NguyenVuQuocMinh/cmos-ldo-regulator-180nm/doc/ldo_hand_design.pdf

# A 1.5 V, 50 mA PMOS Low-Dropout Regulator in 0.18 µm CMOS

### Part 2: Hand calculation of W/L from the specification, and ngspice verification

### November 2026

Abstract

This note sizes a PMOS low-dropout regulator from a written specification and checks it in ngspice. Section 2 extracts square-law parameters from the 0.18 µm BSIM3 model. Section 3 computes every W/L, bias current and resistor step by step, following the system-level LDO design procedure of Rincón-Mora [1, 2]: topology, feedback network, pass device, open-loop gain, transient budget, gain stage, buffer and quiescent current. Section 4 verifies the design, reports four iterations, explains each gap between hand calculation and simulation, and lists the corner results. The final design meets every specification at the nominal point. All equation, lemma, proposition and corollary numbers refer to Part 1 (ldo_theory_proofs.pdf), where each formula is proved; tables, figures and sections refer to this note.

## Contents

1 Specification and architecture | 1
2 Device parameters | 2
3 Hand design: the LDO design procedure | 3
4 Simulation | 5
5 Limitations and next steps | 8
A Reproducing the results | 8

## 1 Specification and architecture

Table 1: Specification. Typical model, T = 27 ◦C unless stated. The last column is the simulated value of the final design (v4, Section 4).

Quantity | Condition | Spec | Simulated (v4)
Input voltage VIN | | 1.7–1.9 V (nom. 1.8 V) | –
Output voltage VOUT | | 1.50 V | 1.4954–1.5053 V
Load current IL | | 0.1–50 mA | –
Dropout voltage | IL = 50 mA, VOUT within 1 % | ≤ 200 mV | 141 mV
Output capacitor | ceramic | CL = 2.2 µF, RESR = 0–50 mΩ | –
Phase margin | all loads, all RESR in range | ≥ 45◦ | 57.0

◦
| | | (worst, incl. corners)
PSRR | 1 kHz, IL = 50 mA, VIN = 1.8 V | ≥ 30 dB | 31.0 dB
Load regulation | IL: 0.1→50 mA | |∆VOUT | ≤ 15 mV | 9.9 mV
Line regulation | VIN : 1.7→1.9 V | ≤ 35 mV/V | 29.9 mV/V (worst)
Quiescent current | excl. IL, incl. divider | ≤ 100 µA | 74.9 µA
Load transient | 0.1↔50 mA, 1 µs edges | |∆VOUT | ≤ 50 mV | 9.9 mV

Process and tools. The transistor model is the 0.18 µm BSIM3v3.1 file cmos180.lib (1.8 V devices, tox = 4.1 nm) from the analog-IC coursework. Simulations use ngspice-46 in batch mode, driven by Python scripts; every number in this note is read from the script outputs. The reference voltage VREF = 0.6 V and the bias current IREF = 5 µA are ideal sources (a bandgap is outside the scope of this note).

Architecture (Fig. 1).

- Pass device MP : a PMOS. A PMOS can work with VIN − VOUT down to its saturation voltage, which is what makes a low dropout possible.
- Feedback divider R1, R2: it feeds back the fraction β = R2/(R1 + R2) of VOUT .
- Error amplifier (EA) M1–M5: a five-transistor OTA with a PMOS input pair, which works at VREF = 0.6 V. An NMOS pair would need its input common mode above VGS + VDS,sat ≈ 0.75 V.
- Buffer MB: a PMOS source follower with its bulk tied to its source, biased by MBS. It drives the large gate capacitance of MP from a low impedance (Part 1, Section 4.2).
- Load: the off-chip capacitor CL with its series resistance RESR. The load current is an ideal current sink.

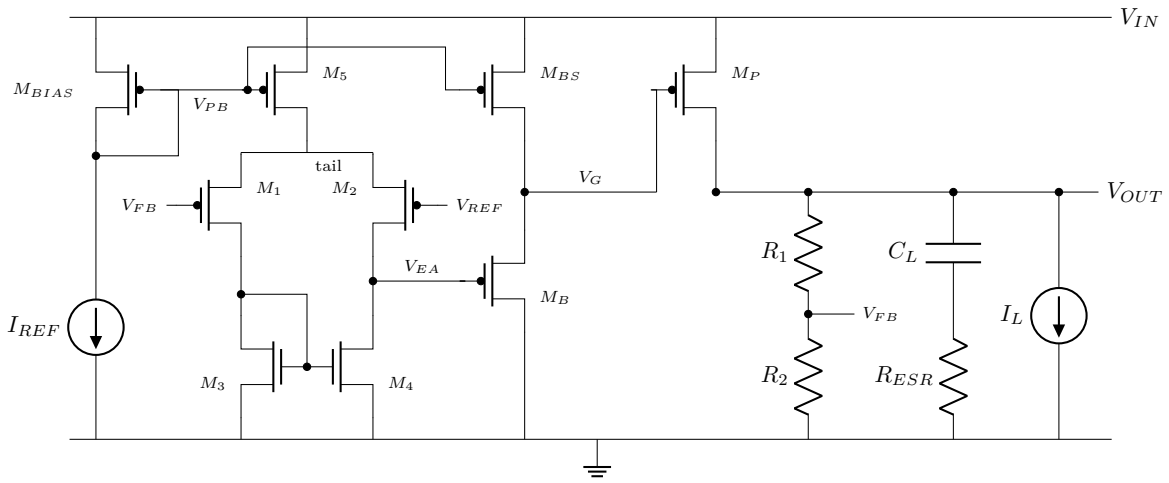
[picture p2: figure]
VIN; MBIAS; IREF; tail; VREF; VEA; MBS; VOUT; RESR

Figure 1: LDO schematic. M1 (gate VF B) sits on the diode side of the mirror, M2 (gate VREF ) on the output side; Lemma 4 shows that this gives negative feedback. Bulk of every PMOS is VIN except M1, M2 (tail node) and MB (its source).

## 2 Device parameters

Extraction. For each device type and length, ngspice sweeps ID–VGS at |VDS| = 0.9 V (W = 10 µm). By (1), √
ID is a straight line in VGS. Its slope gives K′ and its intercept gives VTH; the fit uses VOV = 0.1–0.3 V. Next, λ is the slope of ID–VDS at VOV = 0.2 V over |VDS| = 0.6–1.2 V, divided by ID. Table 2 lists the results, and Fig. 2 shows the simulated gm/ID.

Table 2: Square-law parameters extracted from cmos180.lib (script char_devices.py).

| L = 0.18 µm | 0.5 | 1 | 2 | 3
NMOS VTH (V) | 0.479 | 0.459 | 0.428 | 0.410 | 0.404
NMOS K′
(µA/V²
) | 219 | 218 | 217 | 217 | 216
NMOS λ (V−1
) | 0.292 | 0.101 | 0.080 | 0.059 | 0.045
PMOS |VTH| (V) | 0.465 | 0.431 | 0.412 | 0.399 | 0.394
PMOS K′
(µA/V²
) | 71.4 | 53.9 | 49.9 | 48.0 | 47.4
PMOS λ (V−1
) | 0.342 | 0.118 | 0.077 | 0.046 | 0.032

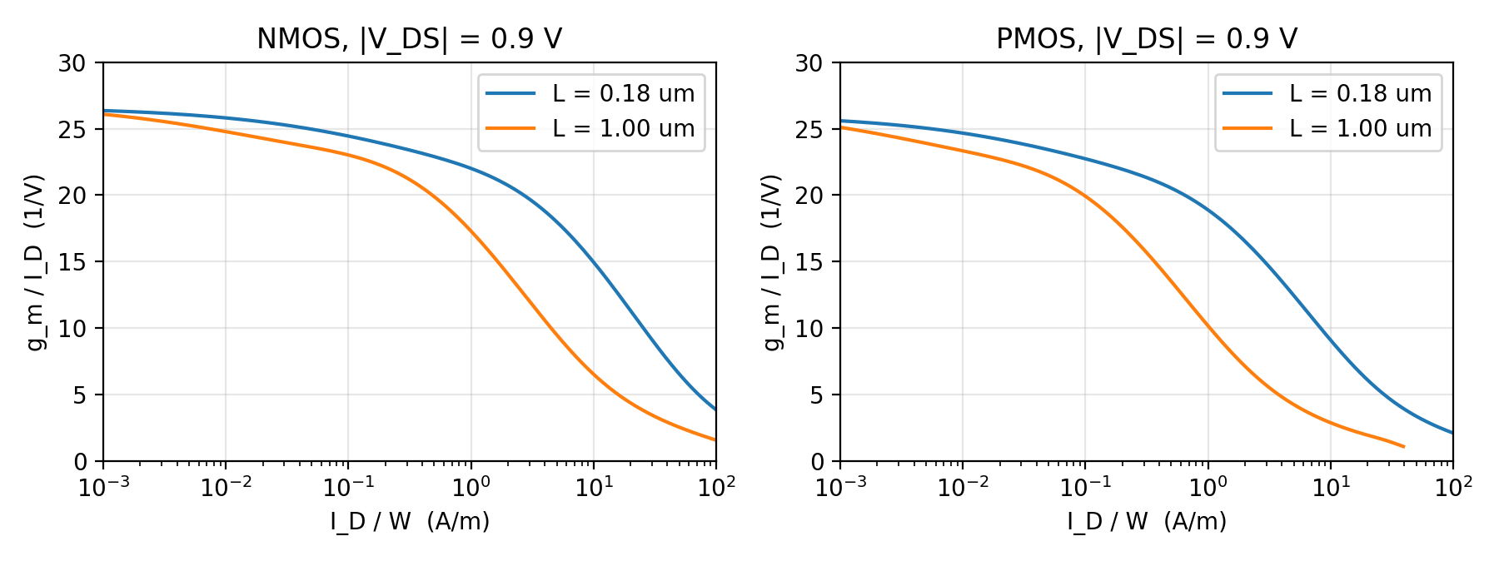
[picture p3: figure]

Figure 2: Simulated gm/ID versus current density. The square law predicts gm/ID = 2/VOV , which is 20 V−1 at
VOV = 0.1 V. The real device gives about 17 V−1
there (moderate inversion) and levels off near 1/(nVT ) ≈ 26 V

−1
in
weak inversion; this is one source of the hand-versus-simulation gap in Section 4.3.

Note on the model file. ngspice reports that the model parameters XL and XW are not recognised and ignores them. In this file XL = 0 and XW = −10 nm, so the effect is a 10 nm width change and is negligible for the widths used here.

## 3 Hand design: the LDO design procedure

The sizing follows the system-level design procedure of Rincón-Mora: the design considerations of [1, Chapter II] (AC analysis, transient analysis, pass device, amplifier), the pass-element choice of [1, Section 6.1], and the dropout, buffer and gain-stage equations of [2, Sections II–IV]. Each formula is used in the form proved in Part 1. The script design_flow.py carries out the eight steps below, and each number is quoted from its output. Steps 6 and 7 run twice. Pass A uses square-law parameters only. Pass B replaces gm/ID and λ by the values read at the simulated operating point of the previous design (v3, Section 4.1), the usual second pass of a hand design. The result is the final design v4.

Step 1 – Topology. Of the five pass elements compared in [1, Table 6.1], the common-source PMOS has the lowest dropout (VSD,sat) together with a low quiescent current, and the reference calls it the best overall choice, so MP is a PMOS. Its large gate capacitance must not load the high-impedance gain stage, so a buffer isolates the two (the buffered architecture of [1, Fig. 2.7]). The gain stage is the five-transistor OTA of [2, Fig. 8(a)], which needs only a small common-mode range around VREF [2, Section IV]. With VREF = 0.6 V a PMOS input pair is used (Step 6a). The buffer is a class-A PMOS source follower MB biased by MBS, with its bulk tied to its source.
Step 2 – Feedback network [1, Section 2.1]. The divider current is a quiescent-current overhead, so it is kept small: IR = 10 µA. Then β = VREF /VOUT = 0.40, R2 = VREF /IR = 60 kΩ and R1 = (VOUT − VREF )/IR = 90 kΩ.
Step 3 – Pass device [2, Eqs. (12)–(14)], [1, Section 2.3]. Two conditions bound W/L from below.
- Dropout. The buffer can pull VG down to VG,min = VOV 4 + VSG,B ≈ 0.80 V (VSG,B is checked in
Step 6b). At VIN,min the available drive is VSG,P = 0.899 V, i.e. VOV = 0.434 V. Carrying Imax at VSD = VDO (triode, (7), the exact form of [2, Eq. (12)]) needs W/L ≥ 10465.
- Saturation at VIN,nom. The loop gain and the PSRR collapse in triode (Corollary 20), so MP must stay saturated at the nominal input. By (6) with a 10 mV margin, W/L ≥ 16644.

The saturation condition is binding. Rounding up to fingers of 10 µm gives MP = 300 × 10 µm/0.18 µm (W/L = 16667). With this size the dropout point needs only V

DO
SG,P = 0.775 V, below the available 0.899 V, and the on-resistance at the available drive is Ron = 1/(K′ W
L

VOV ) = 1.93 Ω [2, Eq. (13)]. At full load VSG,P = 0.755 V and gm,P = 0.345 S. At light load (weak inversion) the simulated ID–VSG curve of one finger gives VSG,P = 0.366 V and gm,P = 2.38 mS, so ∆VSG,P = 389 mV. The gate capacitance, Cpar in [1, 2], is CG =

2
3W LCox + 2W Cov = 6.96 pF.

Step 4 – Open-loop gain from regulation and PSRR [1, Eq. (2.9)]. Equation (2.9) of [1] gives the closed-loop output resistance Ro,pass/(1+Aolβ) ≈ 1/(Ggm,P ) with G = βAEAAB. Since gm,P changes by two
decades over the load range, it is integrated over the range, which is Corollary 6(b): |∆VOUT | = ∆VSG,P /G.
Each specification gives a lower bound on G: PSRR (Proposition 19): G ≥ 31.6; load regulation: G ≥ 25.9; line regulation (Corollary 6c): G ≥ 28.6. The PSRR is binding: Gmin = 31.6.
Step 5 – Transient budget [1, Eqs. (2.10)–(2.12)]. By Proposition 23, the 50 mV limit for the ∆I = 49.9 mA step allows a response time

∆t1,max =

CL (∆Vtr − ∆I RESR)
∆I

= 2.18 µs.

The loop reaction time 1/(2πfu) and the gate slew time (20) must fit in this budget. Steps 6 and 7 check both.

Step 6 – Gain stage [1, Section 2.4], [2, Section IV].
(a) Common-mode range around VREF . For a PMOS pair with an NMOS mirror, VIC,max = VIN,min − VSD,sat5 − VSG1 = 1.038 V and VIC,min = VGS3 − |VTH1| = 0.142 V. VREF = 0.6 V lies inside.
(b) Output swing. The gain stage must move the buffer over the whole range from MP almost off to full drive [2, Section IV]. For this topology that is the window of Proposition 8: 0.522 V ≤ VSG,B ≤ 0.775 V. Its centre, VSG,B = 0.65 V, sets VOV,B = 0.22 V.
(c) Gain and channel lengths. With VOV 1 = 0.1 V, AEA = (2/VOV 1)/(λp + λn) (Lemma 10). By Proposition 16, AEA pEA is fixed for a given L12 and falls as L12 grows, so any gain above the need costs bandwidth. The rule is therefore: the shortest L12, then the shortest L34, whose square-law G exceeds Gmin by 6 dB. The margin covers the known optimism of the square law (gm/ID too high, λ too low; Fig. 2, Section 4.3), which iterations v1 and v2 measured. Table 3 lists the candidates; the rule selects L12 = 1 µm, L34 = 3 µm, with AEA = 164 and G = 64.1.
(d) Current. By Proposition 16, pEA does not depend on ID1, so the bandwidth requirement of [1, Section 2.4] does not fix it; ID1 = 20 µA per side is a budget choice. Then pEA = 2.02 MHz (Pass A).

Table 3: Step 6c, square-law gain for each pair of channel lengths (VOV 1 = 0.1 V, AB = 0.979). The first row that meets G ≥ 2Gmin = 63.2 in the order (L12, L34) is chosen.

L12 (µm) | L34 (µm) | AEA | G | G/Gmin | meets rule
1 | 1 | 127 | 49.8 | 1.58 | no
1 | 2 | 147 | 57.7 | 1.82 | no
1 | 3 | 164 | 64.1 | 2.03 | yes
2 | 1 | 159 | 62.2 | 1.97 | no
2 | 2 | 192 | 75.0 | 2.37 | yes
2 | 3 | 220 | 86.1 | 2.72 | yes
3 | 1 | 177 | 69.5 | 2.20 | yes
3 | 2 | 219 | 85.8 | 2.71 | yes
3 | 3 | 257 | 100.7 | 3.19 | yes
Step 7 – Buffer [2, Eq. (3)], [1, Section 2.4]. The parasitic pole at the gate of MP , pB = gout/(2πCG) (Lemma 11; P3 in [2]), must lie above fu. The worst case is full load [1, Section 2.1] with RESR → 0. Proposition 15 with a target of 60◦

(the specification, 45◦

, plus 15◦
for corners) gives arctan(fu/pB) ≤ 30◦ − arctan(fu/pEA).
- Pass A. fu = 1.60 MHz and arctan(fu/pEA) = 38.3

◦

leave −8.3◦
for the buffer: no bias current reaches the target. The square-law gain, and with it fu, is too high, which is exactly the optimism the 6 dB margin of Step 6c anticipated.
- Pass B. At the operating point of v3: gm1/ID1 = 16.6 V−1

, λ2 = 0.102, λ4 = 0.069 V−1 , so AEA = 97.4
and G = 38.2 (still 1.21 × Gmin). Then fu = 893 kHz, pEA = 2.83 MHz, arctan(fu/pEA) = 17.5

◦
,
and the buffer pole must be at least pB = 4.03 MHz: gmB ≥ 2πCGpBAB = 0.173 mS. With the operating-point gmB/IB = 9.47 V−1
this needs IB ≥ 18.2 µA.
- Slew current. For the load release only IB charges CG (Remark after Proposition 23). With 1/(2πfu) = 0.178 µs, the budget of Step 5 leaves tsr ≤ 2.00 µs, so (20) needs IB ≥ 1.35 µA. The pole condition is binding.

IB = 20 µA (the next multiple of IREF ; v3 used 30 µA). Predictions: pB = 4.42 MHz, PM = 61.1

◦
(RESR = 0)
and 68.1

◦
(RESR = 10 mΩ), tsr = 0.14 µs. The load-step excursion by (19) is at most 29 mV with the conservative tloop = 1/fu of [1], or 7.6 mV with tloop = 1/(2πfu), both within 50 mV. MBS mirrors IREF (WBS = 20 µm) and MB is sized by (1) at VOV,B: WB = 8 µm, LB = 0.5 µm.
Step 8 – Quiescent current and current efficiency [2, Eq. (1)]. IQ = IREF + 2ID1 + IB + IR = 75 µA (v3: 85 µA), within the 100 µA limit. The current efficiency IL/(IL + IQ) is 57 % at 0.1 mA and 99.85 % at 50 mA. Pass B removes the 10 µA by which the buffer of v3 was over-biased, which is the aim of the procedure: the least quiescent current that the stability and transient requirements allow [2].

Table 4: Final device sizes (v4). MBIAS, M5 and MBS form a mirror; the widths set the current ratios. Only MBS and MB differ from v3.

Device | W (µm) | L (µm) | Role / current / set by
MBIAS | 5 | 1 | diode, IREF = 5 µA
M5 | 40 | 1 | tail, 40 µA (Step 6d)
M1, M2 | 81 | 1 | input pair, VOV ≈ 0.1 V (Steps 6a, 6c)
M3, M4 | 25 | 3 | mirror load, VOV ≈ 0.15 V (Step 6c)
MBS | 20 | 1 | buffer bias, 20 µA (Step 7)
MB | 8 | 0.5 | source follower, bulk = source (Steps 6b, 7)
MP | 300 × 10 | 0.18 | pass device (Step 3)
R1 / R2 | 90 kΩ / 60 kΩ | divider (Step 2)

## 4 Simulation

Method. The loop gain uses the break of Proposition 9. A 10⁹ H inductor from the divider tap to the gate of M1 closes the loop at DC, and a 10³ F capacitor injects the AC test voltage at the gate. Because the gate draws no current, this measures (9) exactly for f ≫ 1/(2π

√
LC). The PSRR test puts an AC source on VIN with the loop closed. Line, load and dropout are DC sweeps, and the load step is a transient run with 1 µs edges.

Static output equation. Insert the simulated operating-point voltages and the simulated AEA = gm1/(gds2+ gds4) into (5):

- Light load: ε = 214 mV, so the formula gives VOUT = 1.5055 V. Simulation: 1.5053 V.
- Heavy load: ε =-183 mV, so the formula gives 1.4953 V. Simulation: 1.4954 V.

The equation therefore explains both the ±5 mV output error and its change of sign with load.

### 4.1 Design iterations

Table 5: Four iterations (nominal: VIN = 1.8 V, 27 ◦C, RESR = 10 mΩ; corner columns: VIN ∈ {1.8, 1.9} V, T ∈ {0, 27, 85}

◦C, both load ends). Values that miss the specification are marked with ×.

| v1 | v2 | v3 | v4 (final)
L12 / L34 (µm), VOV,B (V) | 1 / 1, 0.15 | 2 / 2, 0.15 | 1 / 3, 0.22 | 1 / 3, 0.22
Buffer current IB (µA) | 30 | 30 | 30 | 20
Simulated AEA at full load | 76 | 119 | 99 | 99
PSRR at 1 kHz, 50 mA (dB) | 28.8 × | 32.7 | 31.0 | 31.0
Line regulation, worst (mV/V) | 39.1 × | 28.5 | 29.9 | 29.9
PM at 50 mA (deg) | 81.4 | 55.8 | 71.1 | 68.3
PM, RESR = 0, worst corner (deg) | – | 44.4 × | 60.0 | 57.0
PSRR at 1 kHz, worst corner (dB) | – | 22.2 × | 29.8 | 29.8
IQ (µA) | 84.7 | 84.7 | 84.7 | 74.9
- v1 (L = 1 µm everywhere) is stable, with a large margin, but its EA gain is only 76 against 127 by the square law. As a result, PSRR and line regulation miss. This is the gain optimism that the 6 dB margin of Step 6c now covers.

- v2 doubles L for M1–M4. The gain rises, but by Proposition 16 pEA falls (it scales as λ/L), and the phase margin with RESR = 0 drops to 44.4◦ at VIN = 1.9 V, 85 ◦C. At light load and VIN = 1.9 V, VEA also rises to within 0.07 V of the bound VREF + |VTH,p| of Proposition 8. M2 then nears triode and the PSRR falls to 22.2 dB. This is the reason for the shortest-L12 rule of Step 6c.
- v3 lengthens only the mirror (L34 = 3 µm), because the simulated operating point shows that gds4, not gds2, dominates the EA output conductance, and moves VOV,B to the centre of the window (8). Its buffer current, 30 µA, was a budget choice. v3 meets every specification.
- v4 is the outcome of the procedure of Section 3: Step 6c reproduces the lengths of v3, and Pass B of
Step 7 sets the buffer current from the pole and slew conditions, 20 µA. The quiescent current falls by 9.8 µA; the phase margin at full load falls by 2.8◦ and stays above the 60◦
target with RESR = 0 at the nominal point.

### 4.2 Results of the final design

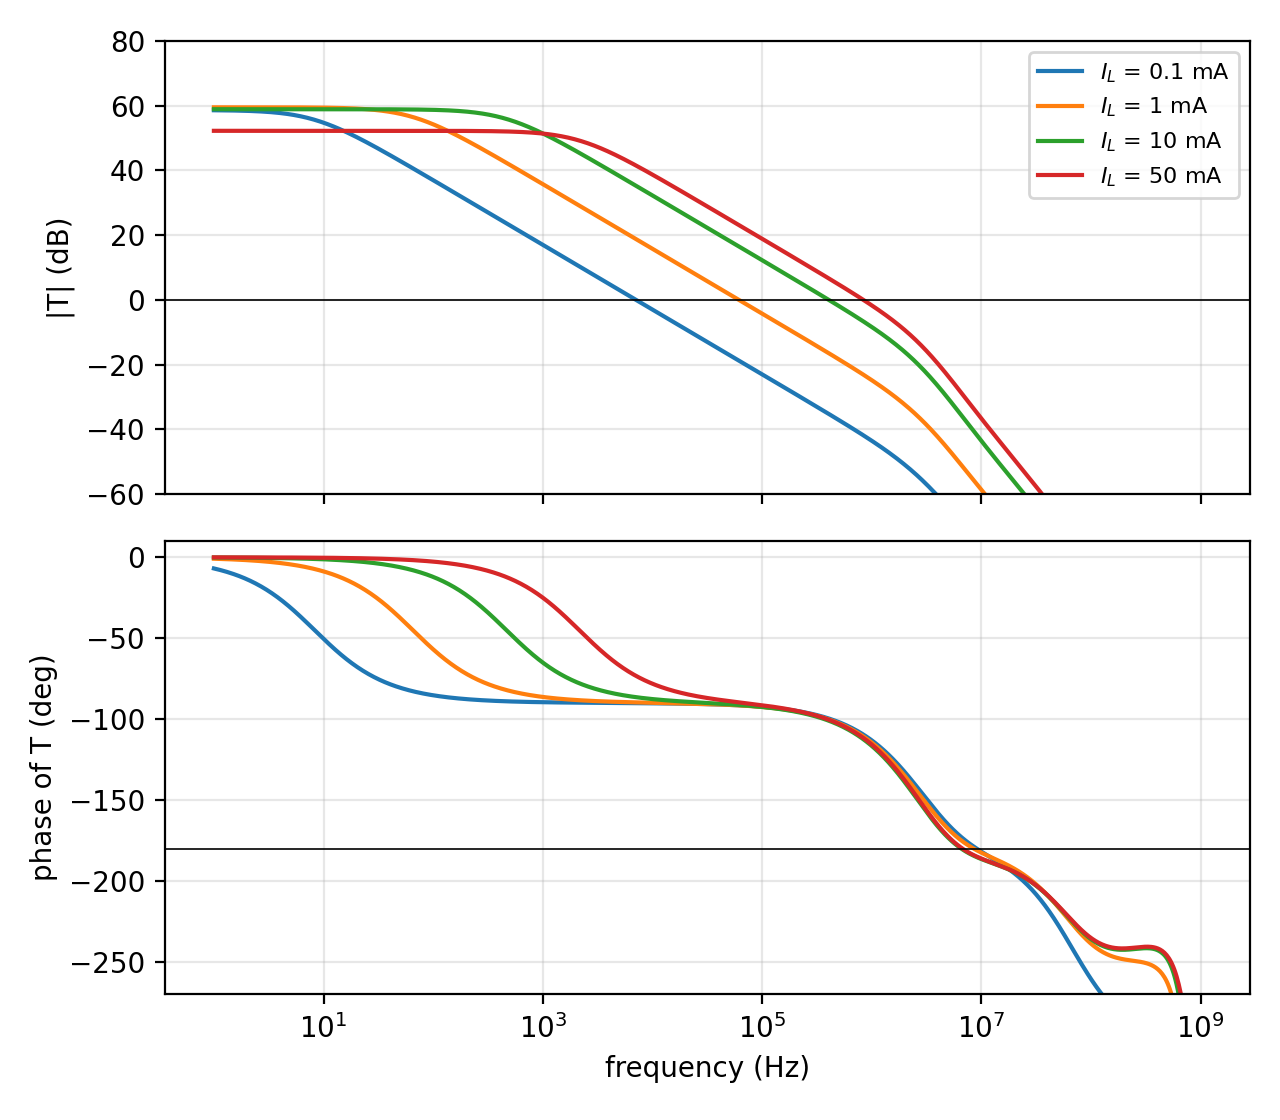
[picture p4: figure]

Figure 3: Loop gain T at four loads. The DC gain is about 52–60 dB, fu moves from 7.1 kHz to 840 kHz with load (Proposition 14), and the PM is 68.3◦
at the worst (full) load.

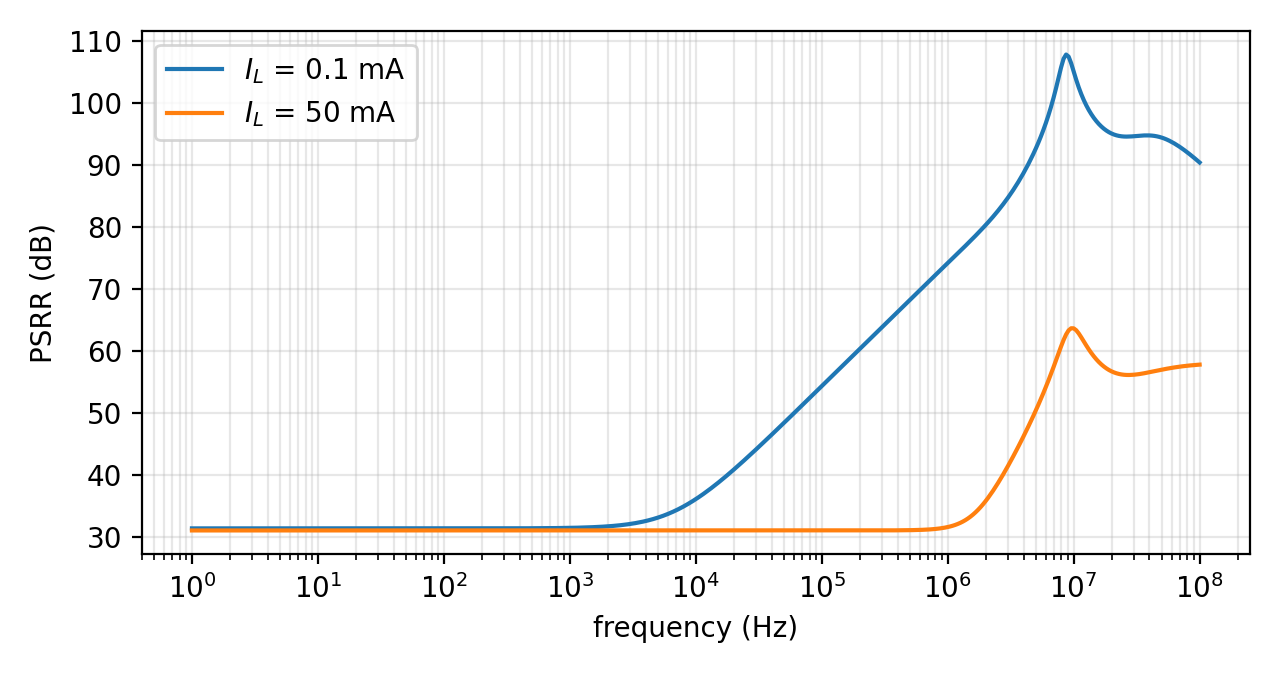
[picture p5: figure]
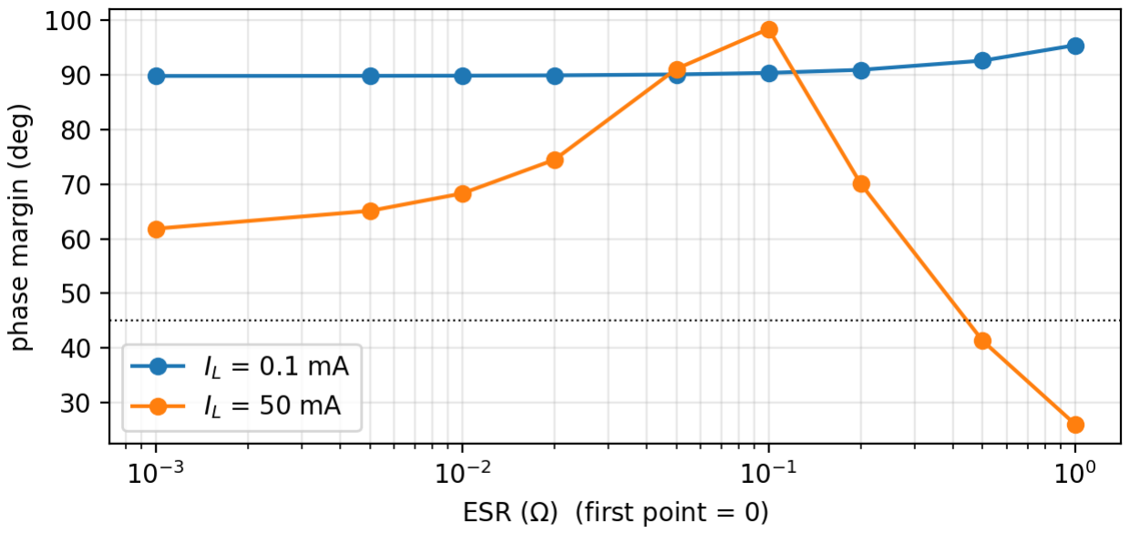
[picture p6: figure]

Figure 4: Left: PSRR. It is flat at about G up to the loop bandwidth, as predicted by (17); above fu the capacitor CL takes over. Right: phase margin versus RESR. The margin first rises (zero lead), peaks near 100 mΩ, then collapses as the plateau of Proposition 17 pushes fu toward pB, pEA. It stays above 45◦ up to 200 mΩ and is 41◦
at 500 mΩ.

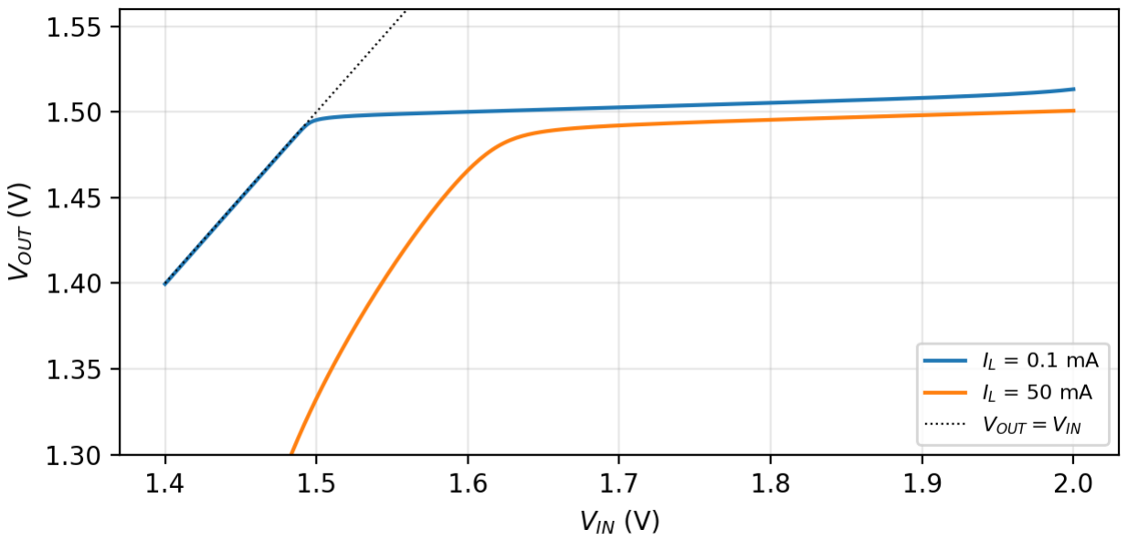
[picture p7: figure]
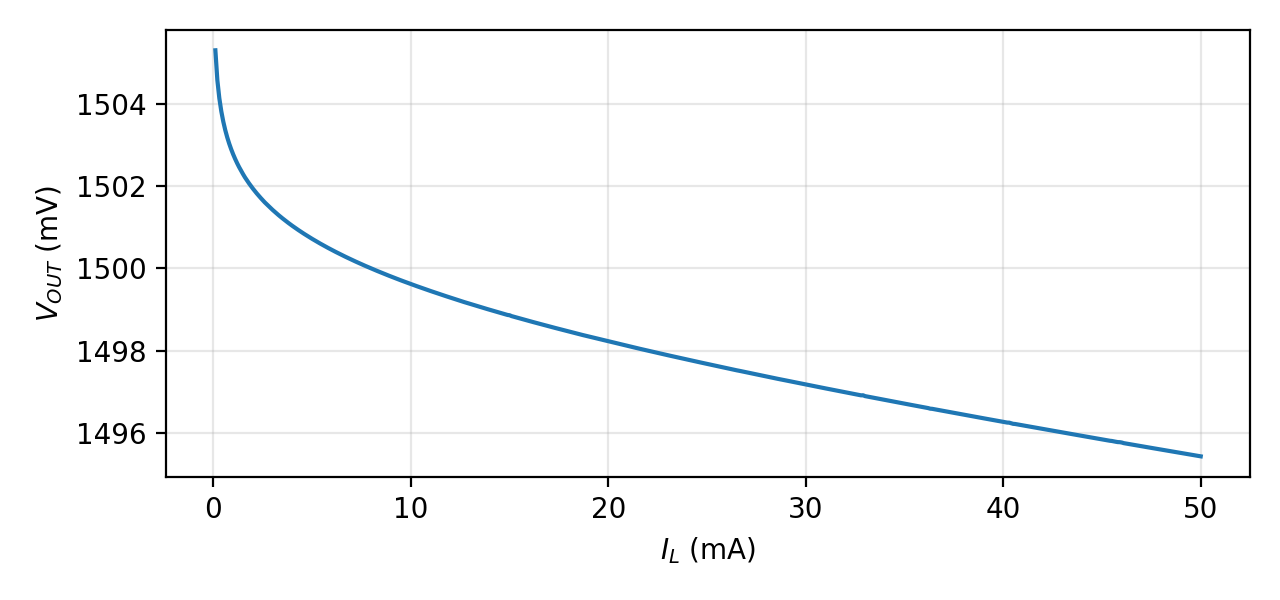
[picture p8: figure]

Figure 5: Left: VOUT versus VIN . The dropout (1 % criterion) at 50 mA is 141 mV. Right: load regulation, ∆VOUT = 9.9 mV over the full range.

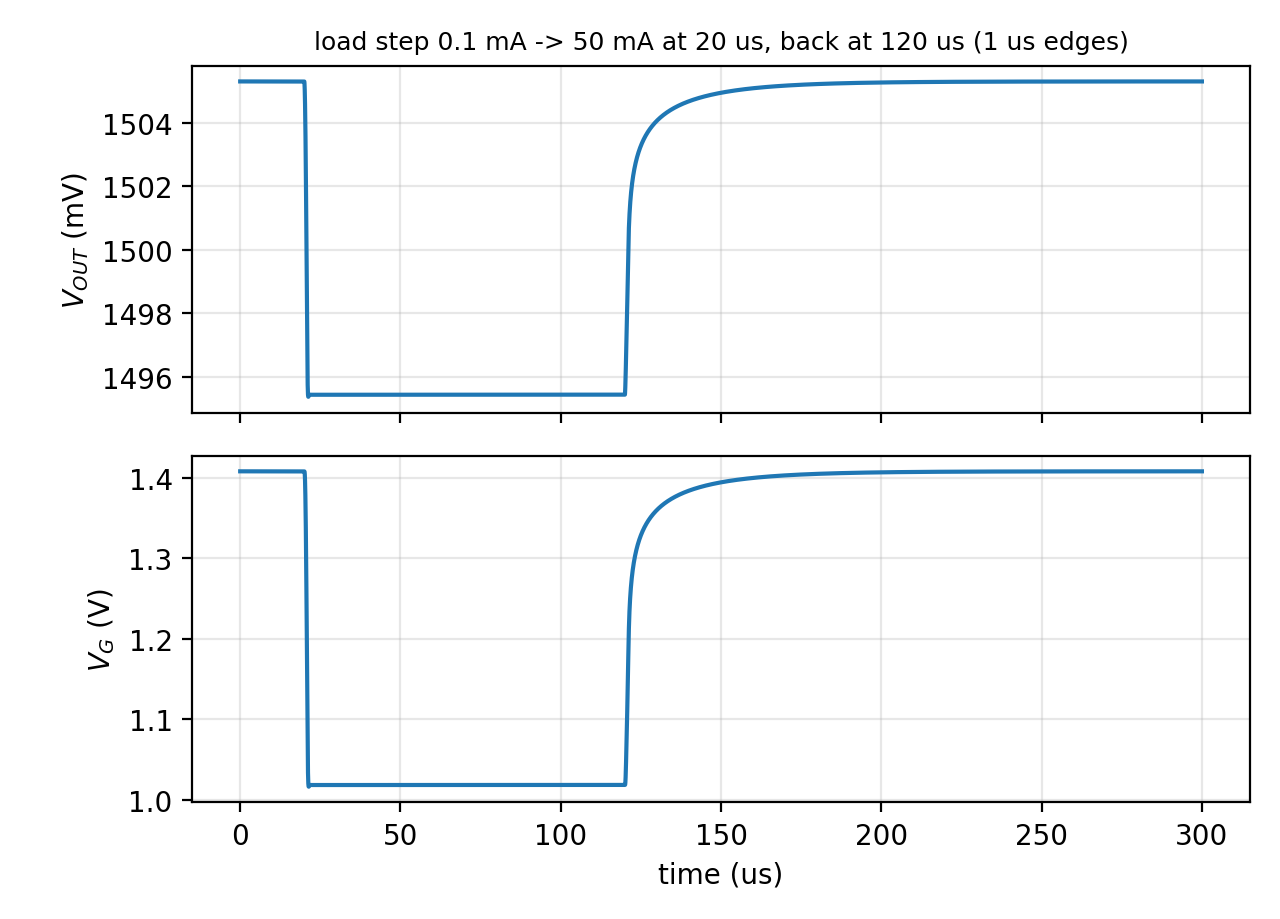
[picture p9: figure]

Figure 6: Load step. The step-up settles within 1 mV immediately (fast loop at full load). The release settles exponentially with a fitted τ = 20.9 µs, against 1/(2πfu,light) = 22.4 µs from Proposition 21. There is no overshoot, as the single-pole model predicts. The total excursion, 9.9 mV, is almost all the static load regulation (9.9 mV).

### 4.3 Hand calculation versus simulation

Table 6: Final design at full load: the two passes of Section 3 and the simulation of v4. Pass A uses square-law parameters; Pass B uses gm/ID and λ read at the v3 operating point.

Quantity (full load) | Pass A | Pass B | Simulated (v4)

gm1/ID1 (V−1
) | 20 | 16.6 | 16.6

λeff of M2 / M4 (V−1
) | 0.077 / 0.045 | 0.102 / 0.069 | 0.102 / 0.069
AEA | 164 | 97 | 99
G = PSRRDC (dB) | 36.1 | 31.6 | 31.0
fu (kHz) | 1599 | 893 | 840
PM, RESR = 10 mΩ (deg) | – | 68.1 | 68.3
PM, RESR = 0 (deg) | – | 61.1 | 61.9
Load regulation (mV) | 6.1 | 10.2 | 9.9
IQ (µA) | – | 75 | 74.9

Pass A misses in two square-law inputs; the formulas themselves hold.
(i) gm/ID. The input pair works at VOV ≈ 0.08 V, in moderate inversion, where gm/ID saturates toward 1/(nVT ) (Fig. 2) instead of following 2/VOV . The simulated value is 16.6 against 20, about 1.6 dB of gain.
(ii) λ. The extraction was done at VOV = 0.2 V and |VDS| = 0.6–1.2 V. In the circuit, M2 has a smaller

VOV and M4 sits at VDS = 0.37 V, close to saturation, where gds is larger. The effective λ values are higher than the table values.
Pass B puts the operating-point values into the same formulas and predicts the phase margin of v4 to within 1

◦
, the loop gain to within 1 dB, fu to within 6 % and the quiescent current to within 1 µA. Because Pass A overestimates G, it overestimates fu and finds no buffer current that reaches the PM target; the second pass is what makes the buffer sizing usable.
The same mechanism affects the pass device. At full load VSD = 0.30 V is close to VDS,sat = 0.22 V, so gds,P = 30 mS against λI = 17 mS. This lowers Ro and the DC loop gain (52.3 dB simulated against 62.2 dB by the square law), but it does not move fu, which is independent of Ro (Proposition 14).

### 4.4 Corners

The model file has no process corners, so the checks cover VIN and temperature only (script sim_extra.py).

- Stability. For VIN ∈ {1.7, 1.8, 1.9} V, T ∈ {0, 27, 85}

◦C and both load ends, the minimum PM is 63.2◦ at RESR = 10 mΩ, and 57.0◦ with RESR = 0 (at 1.9 V, 85 ◦C).

- Output voltage. VOUT stays within 1.4876–1.5088 V over all corners.
- PSRR, VIN ≥ 1.8 V. The worst value is 29.8 dB at 1.9 V, 0 ◦C, 0.1 mA. This is just below the 30 dB specification, which is stated at the nominal point; the cause is the remaining headroom limit of Proposition 8 at high VIN .
- PSRR, VIN = 1.7 V. At full load this is the dropout region, and the PSRR falls to 15.6 dB at 85 ◦C. Corollary 20 explains it: at the 27 ◦C dropout point, the simulated ratio gds,P /gm,P is already 0.33 (against 0.09 at 1.8 V), and it grows further when hot. Datasheets specify PSRR with VIN well above VOUT + VDO for this reason.

## 5 Limitations and next steps

- VREF and IREF are ideal. A bandgap reference and its PSRR would add to the supply path.
- Only the typical model is available: no process corners and no mismatch (Monte Carlo) analysis. Random offset of the input pair adds to ε in (5).
- The design is schematic-level only. Layout parasitics, bond-wire inductance in series with CL, and the pass-device metal resistance are not included.
- Not covered: start-up, current limit and short-circuit protection, noise, and the soft-start of VREF .
- The PSRR is limited to about G by the ground-referenced gate (Corollary 18). Possible improvements are a second EA gain stage with its own compensation, or a gate drive that tracks VIN .

## A Reproducing the results

The scripts, results and document sources are in the GitHub repository https://github.com/NguyenVuQuocMinh/cmos-ldo-regulator-180nm. (https://github.com/NguyenVuQuocMinh/cmos-ldo-regulator-180nm) The 0.18 µm model file is not redistributed there; place a BSIM3 model with .model NMOS and .model PMOS as sim/cmos180.lib, and set the environment variable NGSPICE to the ngspice console executable if it is not at the default path. Run from scripts/:
1. python char_devices.py: device parameters (Table 2, Fig. 2).
2. python design.py: earlier iterations, writes sizes_v1/v2/v3.json and hand.json.
3. For v1–v3: set LDO_SIZES=sizes_vN.json and LDO_VER=vN, then run sim_op.py, sim_all.py and sim_extra.py.
4. python design_flow.py: the procedure of Section 3 (Pass B reads the v3 operating point), writes sizes_v4.json and hand_flow.json. Then run the three simulation scripts for v4.
5. python render.py <path-to-tectonic.exe>: fills this document with the numbers and builds the PDF.
The netlist is generated by ldo_netlist.py from the sizes file. The repository folder netlists/ holds the final circuit (v4) with its operating-point, loop-gain, PSRR and load-step test benches; each runs directly with ngspice_con -b once the model file is in place.

## References

[1] G. A. Rincón-Mora, Current Efficient, Low Voltage, Low Drop-Out Regulators, Ph.D. dissertation, Georgia Institute of Technology, 1996, Chapter II and Section 6.1. Author’s copy: https://rincon-mora.gatech.edu/publicat/books/thesis/ldo_book.pdf. (https://rincon-mora.gatech.edu/publicat/books/thesis/ldo_book.pdf)
[2] G. A. Rincón-Mora and P. E. Allen, “A low-voltage, low quiescent current, low drop-out regulator,” IEEE J. Solid-State Circuits, vol. 33, no. 1, pp. 36–44, Jan. 1998. Author’s copy: https://rincon-mora.gatech.edu/publicat/jrnls/jssc98_lv_ldo.pdf. (https://rincon-mora.gatech.edu/publicat/jrnls/jssc98_lv_ldo.pdf)
