NguyenVuQuocMinh/cmos-ldo-regulator-180nm/doc/ldo_theory_proofs.pdf

# A 1.5 V, 50 mA PMOS Low-Dropout Regulator in 0.18 µm CMOS

### Part 1: Theory and proofs of the design formulas

### November 2026

Abstract

This note derives, with proofs, every formula used to design the low-dropout (LDO) regulator of Fig. 1. It covers the device equations (square law, triode region, weak inversion), the loop polarity, the static output equation (which gives accuracy, load and line regulation in one line), the pass-device and headroom conditions, the loop gain with its poles and zero, the unity-gain frequency and phase margin, the ESR window, the power-supply rejection, the load-step response and the worst-case load-step budget. Part 2 (ldo_hand_design.pdf) applies these formulas to a specification, following the system-level LDO design procedure of Rincón-Mora [1, 2], to size every transistor, and checks the result in ngspice.

## Contents

1 Architecture and notation | 1
2 Device equations | 2
3 Large-signal (DC) analysis | 2
4 Small-signal loop analysis | 4
5 Regulation, power-supply rejection and transient | 6

## 1 Architecture and notation

Architecture (Fig. 1).

- Pass device MP : a PMOS. A PMOS can work with VIN − VOUT down to its saturation voltage, which is what makes a low dropout possible.
- Feedback divider R1, R2: it feeds back the fraction β = R2/(R1 + R2) of VOUT .
- Error amplifier (EA) M1–M5: a five-transistor OTA with a PMOS input pair, which works at VREF = 0.6 V. An NMOS pair would need its input common mode above VGS + VDS,sat ≈ 0.75 V.
- Buffer MB: a PMOS source follower with its bulk tied to its source, biased by MBS. It drives the large gate capacitance of MP from a low impedance (Section 4.2).
- Load: the off-chip capacitor CL with its series resistance RESR. The load current is an ideal current sink.

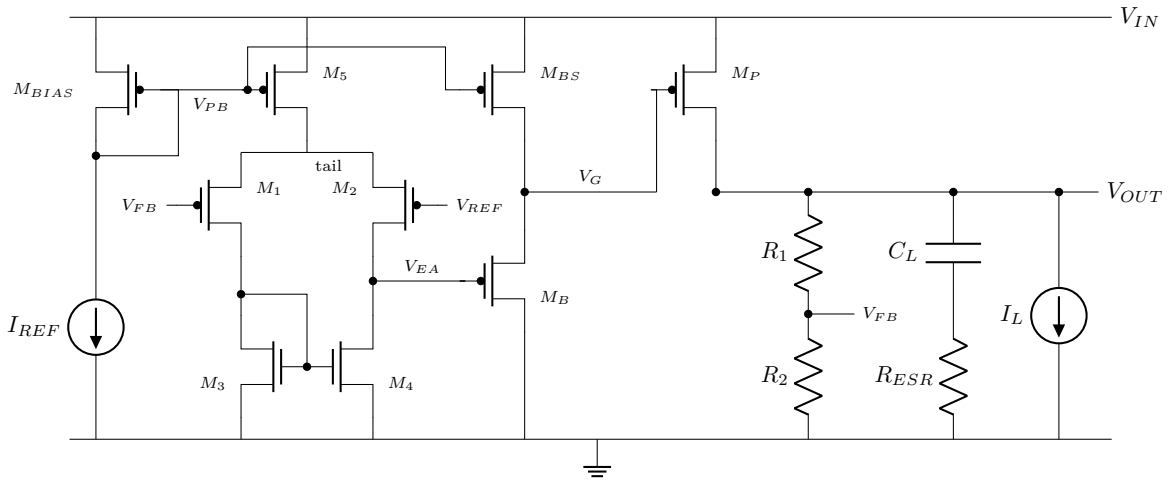
[picture p10: figure]
VIN; MBIAS; IREF; tail; VREF; VEA; MBS; VOUT; RESR

Figure 1: LDO schematic. M1 (gate VF B) sits on the diode side of the mirror, M2 (gate VREF ) on the output side; Lemma 4 shows that this gives negative feedback. Bulk of every PMOS is VIN except M1, M2 (tail node) and MB (its source).

## 2 Device equations

PMOS voltages are written as positive magnitudes (VSG, VSD, |VTH|). The overdrive is VOV = VGS − VTH (NMOS) or VSG − |VTH| (PMOS), and K′ = µCox.

Lemma 1 (Square law and its small-signal parameters). In saturation (VDS ≥ VOV > 0),

ID =

1

2K′ W
L

V

2
OV (1 + λVDS). | (1)

Neglecting λVDS against 1 in the result,

gm =

q
2K′ W
L

ID =

2ID
VOV
, | gds = λID, | ro =

1
λID
. | (2)

Proof. Step 1. gm = ∂ID/∂VGS = K′ (W/L) VOV , by differentiating (1) with λVDS ≪ 1.
Step 2. From (1), VOV =

p
2ID/(K′W/L). Substituting into Step 1 gives gm =

p
2K′(W/L)ID.
Step 3. Dividing gm = K′
(W/L)VOV by ID =

1

2K′
(W/L)V

2
OV gives gm/ID = 2/VOV .
Step 4. gds = ∂ID/∂VDS =

1

2K′ W
L

V

2
OV λ = λID/(1 + λVDS) ≈ λID.

Lemma 2 (Triode region). For 0 ≤ VDS ≤ VOV , ID = K′ W
L
VOV VDS −
1/2 V

2

DS
, so gm = K′ W
L

VDS and
gds = K′ W
L

(VOV − VDS). In particular

gds
gm

=

VOV − VDS
VDS
, | (3)

which grows without bound as VDS falls below VOV .

Proof. Differentiate ID with respect to VGS (only VOV depends on it) and with respect to VDS, then divide the two results.
Lemma 3 (Weak inversion). For VGS below VTH, ID = I0 exp
VGS/(nVT )
| with slope factor n ≈ 1.3–1.5
and VT = kT /q. Then gm = ID/(nVT ).

Proof. gm = ∂ID/∂VGS = I0e

VGS /(nVT )/(nVT ) = ID/(nVT ).

## 3 Large-signal (DC) analysis

### 3.1 Loop polarity

Lemma 4 (Negative feedback). With VF B on M1 (diode side of the mirror) and VREF on M2, a rise of VOUT lowers the pass-device current.

Proof. Step 1. If VOUT rises, VF B = βVOUT rises.
Step 2. Then VSG1 falls, so ID1 falls, while ID2 = Itail − ID1 rises.
Step 3. The mirror makes M4 sink a copy of ID1. The output node therefore receives ID2 and loses only ID1 < ID2, so VEA rises.
Step 4. The source follower gives VG = VEA + VSG,B, so VG rises.
Step 5. VSG,P = VIN − VG falls, so the current of MP falls, which opposes the rise of VOUT .

### 3.2 The static output equation

Linearise the EA around the balanced point. When VF B = VREF , the two halves carry equal currents, so VDS4 = VDS3 = VGS3 and VEA = VGS3. Writing AEA for the EA gain and using Lemma 4 for the sign gives

VEA = VGS3 + AEA (VF B − VREF ). | (4)

Proposition 5 (Static output equation). Let VSG,P (I) be the source–gate voltage that makes MP carry I = IL + Idiv. Then

VOUT =

VREF
β

+

ε
βAEA
, | ε ≡ VIN − VSG,P (IL + Idiv) − VSG,B − VGS3. | (5)

Proof. Step 1. The gate of MP sits at VG = VIN − VSG,P , because MP must carry IL + Idiv.
Step 2. The follower gives VEA = VG − VSG,B = VIN − VSG,P − VSG,B.
Step 3. Set this equal to (4) with VF B = βVOUT : VIN − VSG,P − VSG,B = VGS3 + AEA(βVOUT − VREF ).
Step 4. Solve for VOUT : βAEAVOUT = AEAVREF + (VIN − VSG,P − VSG,B − VGS3).
Step 5. Divide by βAEA.

Proposition 5 contains three specifications at once.

Corollary 6. (a) Ideal value: as AEA → ∞, VOUT → VREF /β = VREF (1 + R1/R2).
(b) Load regulation: only VSG,P depends on IL, so ∆VOUT = −∆VSG,P /(βAEA) between two loads.
(c) Line regulation: with VSG,P , VSG,B, VGS3 fixed by their currents, ∂VOUT /∂VIN = 1/(βAEA).
(d) Systematic offset: ε is the difference VDS4 − VDS3 that the loop has to create. The output error at a given load is ε/(βAEA), and it changes sign between light and heavy load.
When the follower gain AB < 1 is kept (Section 4.2), AEA becomes AEAAB in (b) and (c).

### 3.3 Pass device: saturation and dropout

Proposition 7 (Pass-device sizing). (a) MP stays saturated at IL = Imax and VIN = VIN,nom if

W
L

≥

| 2Imax
| K′ (VIN,nom − VOUT )
| 2
| . | (6)
(b) At VSD = VDO (triode), carrying Imax needs the overdrive

VOV =

| Imax
K′ W
| L

VDO

+

VDO
2
| . | (7)

The dropout specification is met if the drive chain can pull VG down to VIN − |VTH| − VOV .

Proof. Step 1. (a) Saturation needs VSD ≥ VOV , and VSD = VIN,nom − VOUT .
Step 2. Use (1) at the edge VOV = VSD: Imax ≤
| 1

2K′ W
L

(VIN,nom − VOUT )

2
. Rearranging gives (6).
Step 3. (b) Lemma 2 at VDS = VDO: Imax = K′ W
L

(VOV VDO −
1/2 V

2
DO).
Step 4. Divide by K′ W
L

VDO and move VDO/2 to the right-hand side. This is (7).

### 3.4 Headroom window of the error-amplifier output

Proposition 8 (Buffer VSG window). M2 and M4 stay saturated over the whole input and load range if

VIN,max − VSG,P (Imin) − VREF − |VTH,p|
| | {z | }
lower bound

≤ VSG,B ≤ VIN,min − V

DO
SG,P (Imax) − VOV 4
| | {z | }
upper bound

, (8)

where V

DO
SG,P is the pass-device VSG at the dropout point.

Proof. Step 1. M2 saturated: VSD2 ≥ VOV 2, i.e. Vtail − VEA ≥ VSG2 − |VTH,p|.
Step 2. The tail sits one VSG above the gate of M2: Vtail = VREF +VSG2. Substitute: VEA ≤ VREF +|VTH,p|.
Step 3. M4 saturated: VDS4 = VEA ≥ VOV 4.
Step 4. From the proof of Proposition 5, VEA = VIN − VSG,P − VSG,B.
Step 5. VEA is largest at VIN,max and light load (small VSG,P ). Insert into Step 2 and solve for VSG,B: this is the lower bound.
Step 6. VEA is smallest at VIN,min and full load. Insert into Step 3 and solve for VSG,B: this is the upper bound.

## 4 Small-signal loop analysis

### 4.1 Loop gain

Proposition 9 (Loop gain). Break the loop at the gate of M1 and inject vt there. Then

T(s) ≡ −

vf b
vt

= β AEA(s) AB(s) gm,P Zo(s), Zo(s) = Ro

RESR +

1
sCL
, Ro = ro,P ∥ (R1 +R2). (9)

Proof. Step 1. The gate of M1 draws no current, so breaking the loop there leaves the divider unloaded and the break is exact.
Step 2. EA: vea = AEA(s)vt (Lemma 10 below; the sign is positive by Lemma 4).
Step 3. Buffer: vg = AB(s)vea (Lemma 11).
Step 4. Pass device, with vin = 0: the drain current into the output node is i = gm,P vsg = −gm,P vg.
Step 5. Output node: vout = i Zo. Here Zo is the drain resistance, the divider and the capacitor branch in parallel; the ideal current-sink load adds nothing.
Step 6. Divider: vf b = βvout = −βgm,P ZoABAEAvt.
Step 7. Divide by −vt.

Lemma 10 (Five-transistor OTA). At low frequency, AEA =

gm1

gds2 + gds4

, and the output pole is pEA =

1
2πRo,EACEA

with Ro,EA = 1/(gds2 + gds4), where CEA is the total capacitance at the EA output.

Proof. Step 1. Ideal tail: i1 + i2 = 0, where ik is the small-signal drain current of Mk toward the mirror.
Step 2. i1 = −gm(vf b − vx) and i2 = −gm(vref − vx), with vx the tail voltage (PMOS: a higher gate means less current).
Step 3. Adding the two and using Step 1 gives vx = (vf b + vref )/2, so i1 = −gmvd/2 with vd = vf b − vref .
Step 4. The mirror sinks i1 at the output, and M2 sources i2 = −i1. The net current into the output node is i2 − i1 = −2i1 = gmvd.
Step 5. This current flows into gds2 + gds4 in parallel with sCEA: vea = gmvd/(gds2 + gds4 + sCEA).
Step 6. At s = 0 this is AEA. The single pole sits at (gds2 + gds4)/(2πCEA). The mirror pole gm3/Cd1 is far higher and is neglected.

Lemma 11 (PMOS source follower). With the bulk tied to the source and CG the load capacitance at VG,

AB(s) = gmB
gout + sCG
, | gout = gmB + gdsB + gds,BS, | AB =

gmB

gout

, pB =

gout
2πCG

. (10)

Proof. Step 1. MB carries i = gmBvsg + gdsBvsd = gmB(vg − vea) + gdsBvg from VG to ground. No gmb term appears because vbs = 0.
Step 2. MBS (gate fixed) delivers −gds,BSvg into the node.
Step 3. KCL at VG: −gds,BSvg = gmB(vg − vea) + gdsBvg + sCGvg.
Step 4. Collect the vg terms: vg(gout + sCG) = gmBvea.

Remark 12 (Which capacitance loads VG). CG = Cgs,P + Cgd,P , with no Miller multiplication of Cgd,P . The reason is that at the frequencies where pB matters (near fu), CL already holds the drain of MP at AC ground, so the gain from gate to drain is about zero. In saturation, Cgs ≈

2
3W LCox + W Cov and Cgd ≈ W Cov.

### 4.2 Poles, zero and unity-gain frequency

Lemma 13 (Output pole and ESR zero).

Zo(s) = Ro

1 + sRESRCL
1 + s(Ro + RESR)CL

, po =

1
2π(Ro + RESR)CL

, zESR =

1
2πRESRCL

. (11)

Proof. Zo = Ro(RESR + 1/sCL)/(Ro + RESR + 1/sCL). Multiply the numerator and the denominator by sCL.

Proposition 14 (Unity-gain frequency). If po ≪ fu ≪ zESR, pB, pEA, then

fu ≈

G gm,P
2πCL
, | G ≡ βAEAAB, | (12)

independent of Ro. Since gm,P rises with IL, the highest fu occurs at full load.

Proof. Step 1. For f ≫ po, |sCL| ≫ 1/Ro; for f ≪ zESR, RESR ≪ 1/|sCL|. Hence Zo ≈ 1/(sCL).
Step 2. For f ≪ pB, pEA, AEA(s)AB(s) ≈ AEAAB.
Step 3. By (9), |T(j2πf)| ≈ Ggm,P /(2πfCL). Setting this equal to 1 gives (12).

Proposition 15 (Phase margin). Under the same conditions,

PM ≈ 90◦ − arctan

fu
pB
| − arctan fu pEA + arctan

fu

zESR

. | (13)

Proof. Step 1. The phase of T is the sum of the phases of its factors: − arctan(f /po) − arctan(f /pB) − arctan(f /pEA) + arctan(f /zESR).
Step 2. At f = fu ≫ po, the first term is −90◦ + arctan(po/fu) ≈ −90◦
Step 3. PM = 180◦ + ∠T(fu).

Proposition 16 (The EA pole does not depend on the EA current). Hold VOV 1 fixed and size M1, M2 by (1). If CEA is dominated by the drain capacitance of M2, with c

′
its value per unit width, then

pEA ≈

(λp + λn) K′ V
2
OV 1
4πc′L12

, AEA pEA ≈

K′ VOV 1
2πc′L12
. | (14)

Proof. Step 1. By Lemma 10, pEA = (λp + λn)ID1/(2πCEA).
Step 2. By (1), W12 = 2ID1L12/(K′V
2
OV 1

), so CEA ≈ c

| ′W12 = 2c

′

| ID1L12/(K′V
2
OV 1

).
Step 3. Substitute Step 2 into Step 1: ID1 cancels, which gives the first formula.
Step 4. Multiply by AEA = (2/VOV 1)/(λp + λn) (Lemmas 1 and 10). This gives the second.

So the EA current is free; it only sets slew rate and power. Gain and bandwidth trade through VOV 1 and L. A longer L lowers λ (more gain) but also lowers pEA, which is the mechanism behind the design iterations in Part 2.

Proposition 17 (ESR window). For f ≫ zESR, Zo → Ro∥RESR ≈ RESR and |T| → Ggm,P RESR. The crossover stays on the single-pole slope if

RESR <

1

G gm,P

. | (15)

This condition is sufficient, not necessary. A moderate RESR adds phase lead (the + arctan term in (13)). A large RESR flattens |T| above zESR and moves fu up toward pB and pEA, so the PM collapses.

Proof. Step 1. By (11), Zo(s) → RoRESR/(Ro + RESR) as s → ∞, which is about RESR for RESR ≪ Ro.
Step 2. Between zESR and min(pB, pEA), |T| ≈ Ggm,P RESR, which is flat.
Step 3. If that plateau is below 1, |T| crossed 1 before zESR, on the −20 dB/dec slope where Proposition 15 applies.

Corollary 18 (The central trade-off). With the gate of MP referred to ground (next section), the low-frequency PSRR is about G. By (12),
fu ≈ PSRRDC ·

gm,P
2πCL
. | (16)

Each extra dB of PSRR raises fu by the same factor, and fu must stay below pB and pEA. With a single-stage EA, this is the constraint that sets the achievable PSRR.

## 5 Regulation, power-supply rejection and transient

Proposition 19 (Power-supply rejection). Treat VG as referred to ground: the EA output is set by the NMOS mirror, and MBS is a high impedance. Then

vout

vin

(s) = (gm,P + gds,P )Zo(s)
1 + T(s)

, PSRRDC ≈

G

1 + gds,P /gm,P

(T0 ≫ 1). | (17)

Proof. Step 1. The current of MP into the output is gm,P (vin − vg) + gds,P (vin − vout).
Step 2. Loop: vg = ABAEAβvout (Proposition 9, steps 2–3 and 6).
Step 3. Output node: vout/Z′
o = gm,P (vin − Gvout) + gds,P (vin − vout), where Z

′
o

excludes ro,P .
Step 4. Move the gds,P vout term to the left. Since 1/Z′
o + gds,P = 1/Zo: vout(1/Zo + gm,P G) = (gm,P +

gds,P )vin.
Step 5. Multiply by Zo and use T = Ggm,P Zo. This gives the first formula.
Step 6. At DC with T0 = Ggm,P Ro ≫ 1: vout/vin ≈ (gm,P + gds,P )/(Ggm,P ). Invert.

Corollary 20 (PSRR near dropout). In saturation gds,P /gm,P = λVOV /2 is small and PSRRDC ≈ G. Near dropout, MP enters the triode region, and by (3) gds,P /gm,P = (VOV − VSD)/VSD grows. The PSRR then drops even though the EA is unchanged. The line regulation is the DC value of (17), so it degrades in the same way.

Proposition 21 (Load-step response). On the single-pole part of the loop (po ≪ f ≪ pB, pEA, RESR → 0), the closed-loop output impedance is Zcl(s) = Zo/(1 + T) ≈ 1/

CL(s + ωu)
with ωu = 2πfu. A load step ∆I therefore gives

∆VOUT (t) = −

∆I
CL ωu
1 − e

−ωut

, | (18)

a monotone settling with time constant τ = 1/ωu = CL/(Ggm,P ) and no overshoot.

Proof. Step 1. In this range, Zo ≈ 1/(sCL) and T ≈ ωu/s (Proposition 14).

Step 2. Zcl =

1/(sCL)
1 + ωu/s =

1
CL(s + ωu)
Step 3. A step −∆I/s (current drawn from the output) gives ∆V (s) = −∆I/ sCL(s + ωu)
Step 4. Partial fractions: 1 s(s + ωu)

=

1
ωu

1

s

−

1
s + ωu
. The inverse transform gives (18).

Remark 22 (Large steps). For the 0.1 ↔ 50 mA step, gm,P itself changes by two orders of magnitude, so (18) is used piecewise. The final level comes from Corollary 6(b). The settling after a load release is slow, because it ends at light load where ωu is small: τlight = 1/(2πfu,light). The gate must also slew up by ∆VSG,P , but only with the bias current of MBS, which takes tslew = CG∆VSG,P /IB. In Part 2 this is below 0.2 µs, far shorter than τlight.
The design procedure of Part 2 needs a bound that holds for a large step, before any linear model applies. It is the response-time budget of Rincón-Mora [1, Eqs. (2.10)–(2.12)]; the statement and proof below are written for the circuit of Fig. 1.

Proposition 23 (Worst-case load-step budget). Let the load current rise by ∆I at t = 0. Let ∆t1 be the time after which MP carries the full new load current, and assume that the current of MP does not fall during 0 ≤ t ≤ ∆t1. Then the output excursion is bounded by

|∆VOUT | ≤ ∆I ∆t1
CL
+ ∆I RESR, | (19)

and ∆t1 ≈ tloop + tsr, where tloop is the reaction time of the loop and

tsr =

CG ∆VSG,P

Isr

(20)

is the time needed to move the gate of MP by ∆VSG,P when that node can be driven only with the current Isr. On the single-pole part of the loop (Proposition 21) the limit of (18) equals the first term of (19) with tloop = 1/(2πfu). Reference [1] uses tloop = 1/BWcl with BWcl ≈ fu in hertz, which is larger by 2π and therefore more conservative.

Proof. Step 1. The load current is IL + ∆I for t > 0. Let iP (t) be the extra current of MP . KCL at the output: the capacitor branch delivers iC = ∆I − iP (the divider current changes by less than ∆VOUT /(R1 + R2), which is negligible).
Step 2. By assumption 0 ≤ iP ≤ ∆I on [0, ∆t1] and iP = ∆I afterwards (up to the static regulation term). Hence 0 ≤ iC ≤ ∆I on [0, ∆t1] and iC = 0 later.
Step 3. The capacitor loses the charge R ∞

0

iC dt ≤ ∆I ∆t1, so its voltage falls by at most ∆I ∆t1/CL.
Step 4. The output is the capacitor voltage minus iC RESR, and iC ≤ ∆I. Adding this drop gives (19).
Step 5. Before iP can reach ∆I, VSG,P must change by ∆VSG,P (the ID–VSG curve of MP ). This takes the charge CG∆VSG,P ; with a drive current of at most Isr it takes at least (20), which adds to the reaction time of the loop.
Step 6. In the single-pole case, (18) tends to ∆I/(CLωu) as t → ∞, which is the first term of (19) with ∆t1 = 1/ωu = 1/(2πfu).

Remark 24 (Direction of the slew limit). The buffer is class A [1, Sec. 2.2]. When the load rises, VG must fall, and MB pulls it down with a current that grows with its overdrive, so this direction is not slew limited. When the load is released, VG must rise, and only the bias current of MBS charges CG: Isr = IB in (20). The bound (19) applies to the release with the signs reversed.

## References

[1] G. A. Rincón-Mora, Current Efficient, Low Voltage, Low Drop-Out Regulators, Ph.D. dissertation, Georgia Institute of Technology, 1996, Chapter II and Section 6.1. Author’s copy: https://rincon-mora.gatech.edu/publicat/books/thesis/ldo_book.pdf. (https://rincon-mora.gatech.edu/publicat/books/thesis/ldo_book.pdf)
[2] G. A. Rincón-Mora and P. E. Allen, “A low-voltage, low quiescent current, low drop-out regulator,” IEEE J. Solid-State Circuits, vol. 33, no. 1, pp. 36–44, Jan. 1998. Author’s copy: https://rincon-mora.gatech.edu/publicat/jrnls/jssc98_lv_ldo.pdf. (https://rincon-mora.gatech.edu/publicat/jrnls/jssc98_lv_ldo.pdf)
