NguyenVuQuocMinh/cmos-ldo-regulator-180nm/figures/line_dropout_v1.png

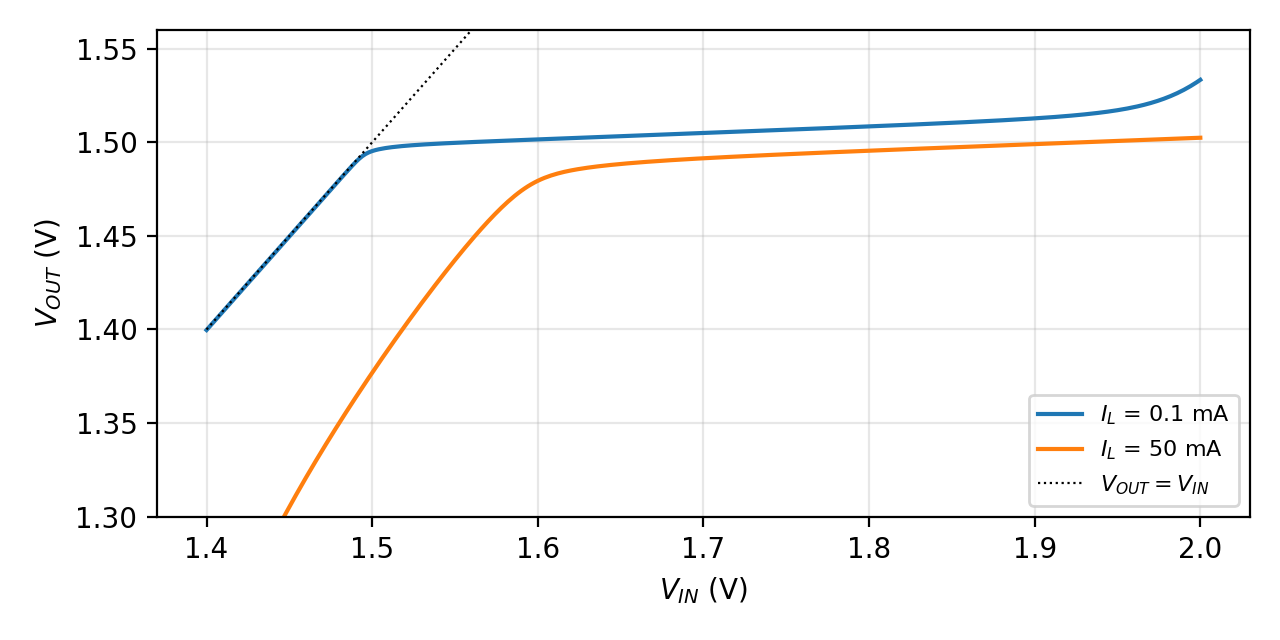
figures/line_dropout_v1.png
