NguyenVuQuocMinh/cmos-ldo-regulator-180nm/figures/pm_vs_esr_v1.png

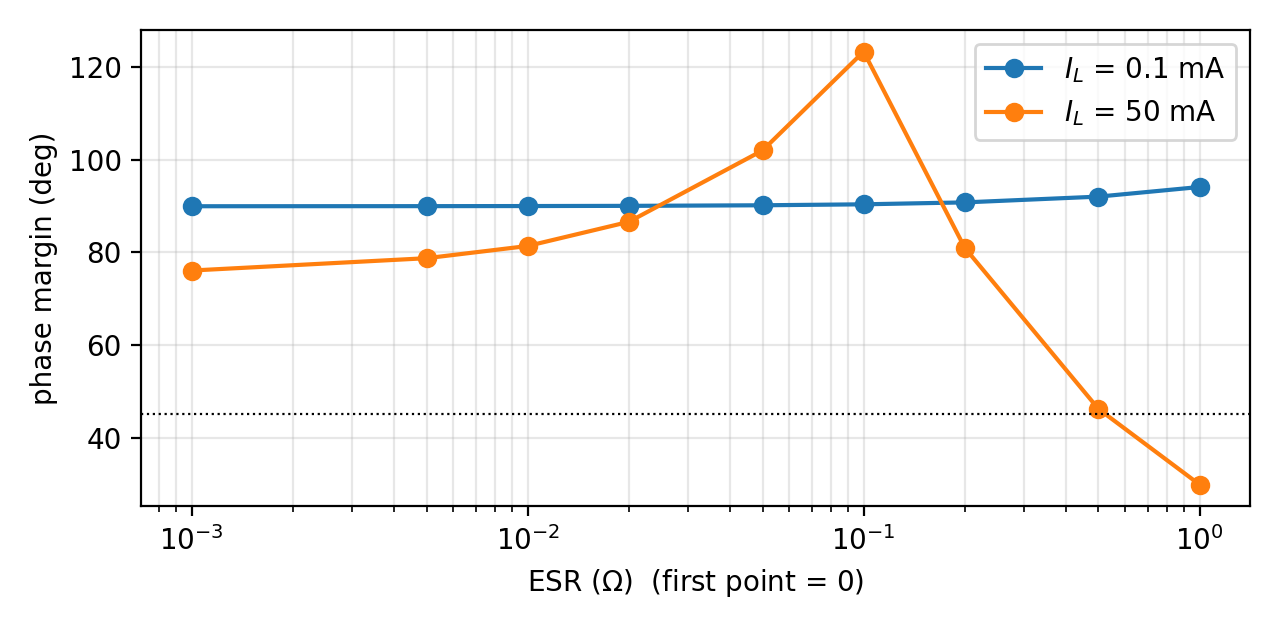
figures/pm_vs_esr_v1.png
