NguyenVuQuocMinh/cmos-ldo-regulator-180nm/figures/pm_vs_esr_v2.png

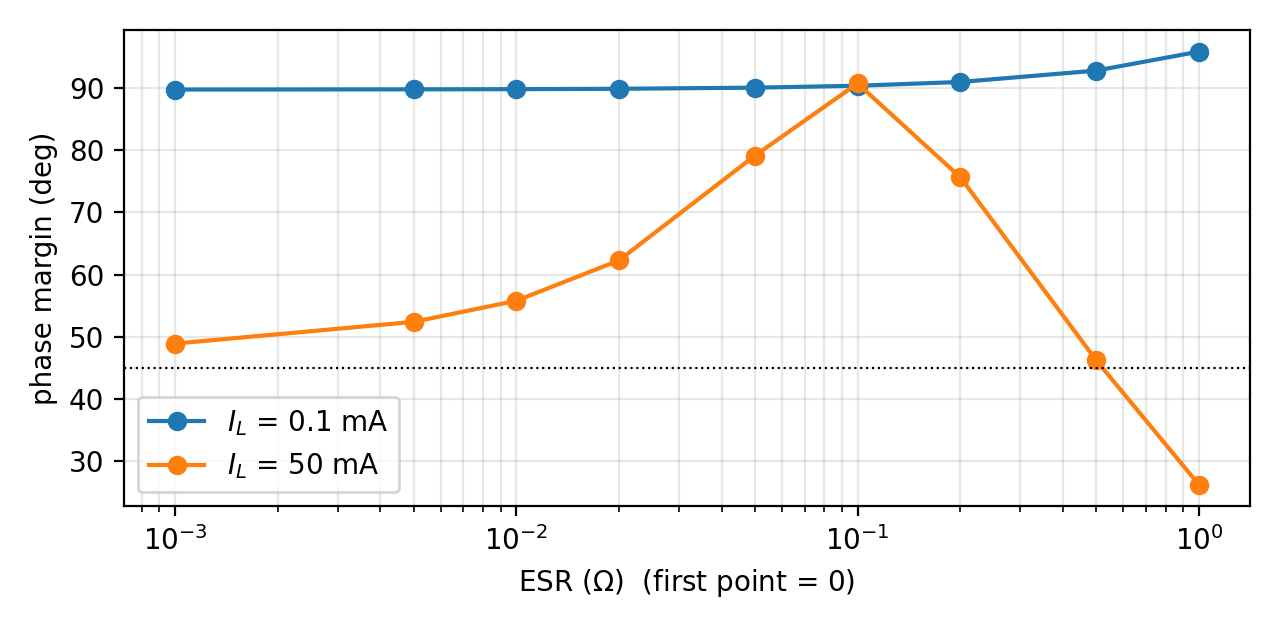
figures/pm_vs_esr_v2.png
