NguyenVuQuocMinh/cmos-ldo-regulator-180nm/figures/pm_vs_esr_v3.png

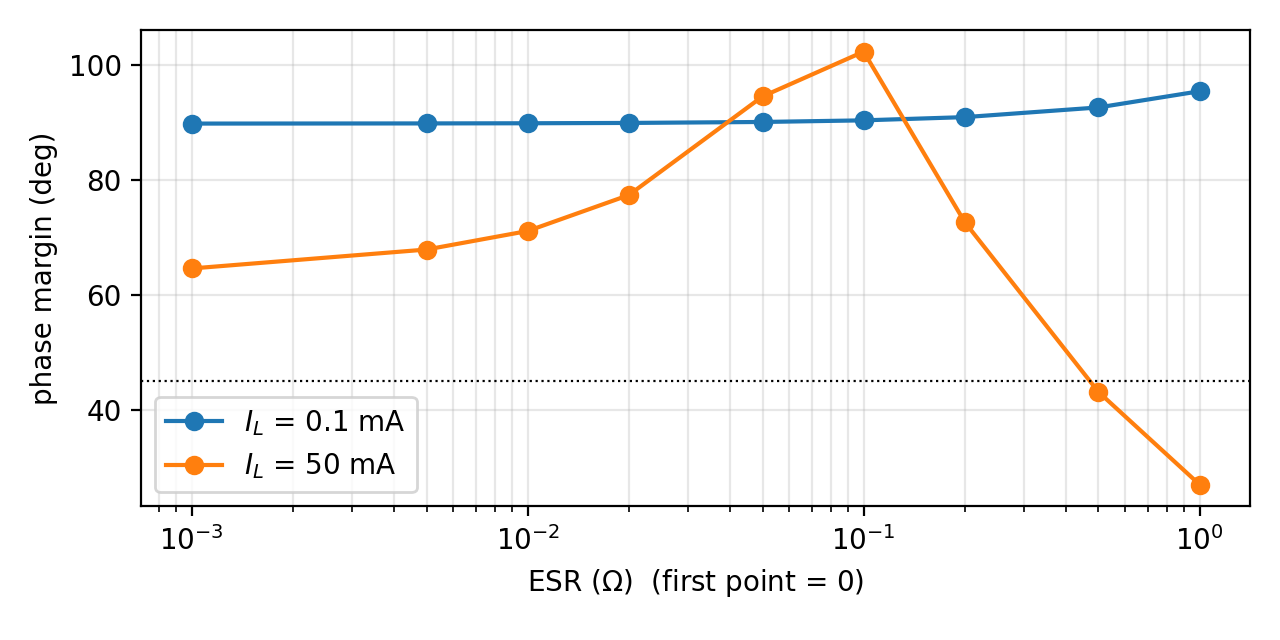
figures/pm_vs_esr_v3.png
