NguyenVuQuocMinh/cmos-ldo-regulator-180nm/figures/psrr_v1.png

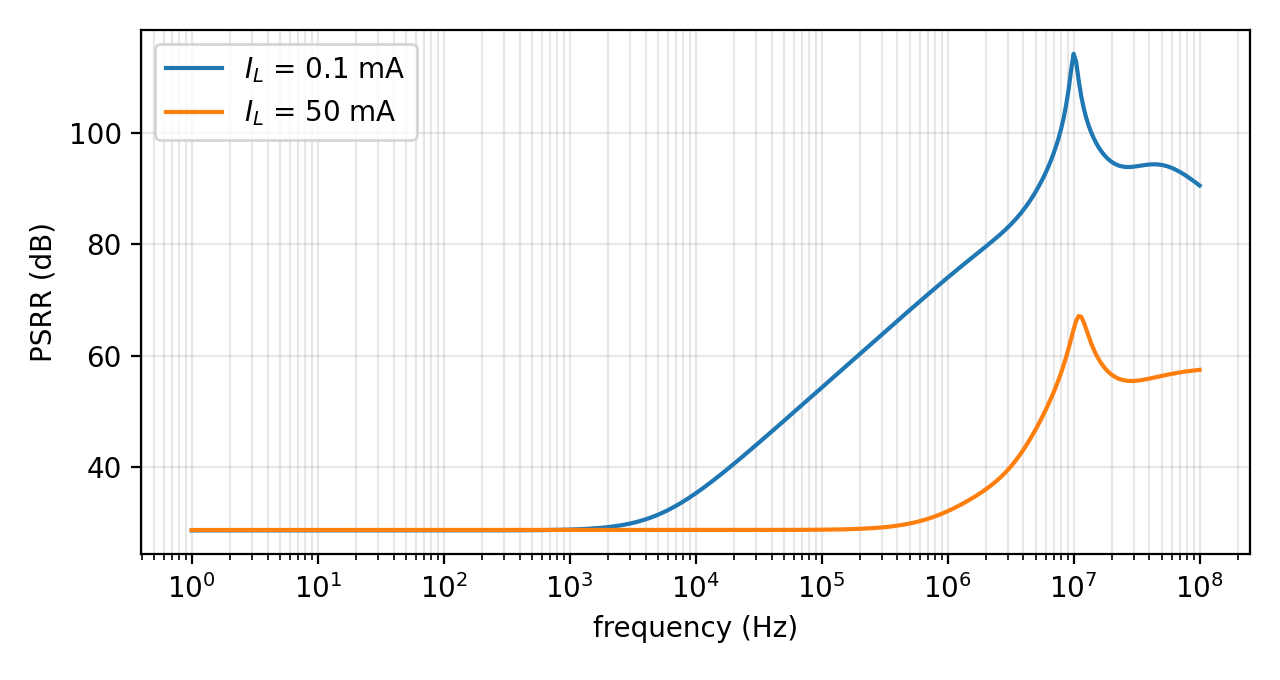
figures/psrr_v1.png
