NguyenVuQuocMinh/cmos-ldo-regulator-180nm/figures/psrr_v2.png

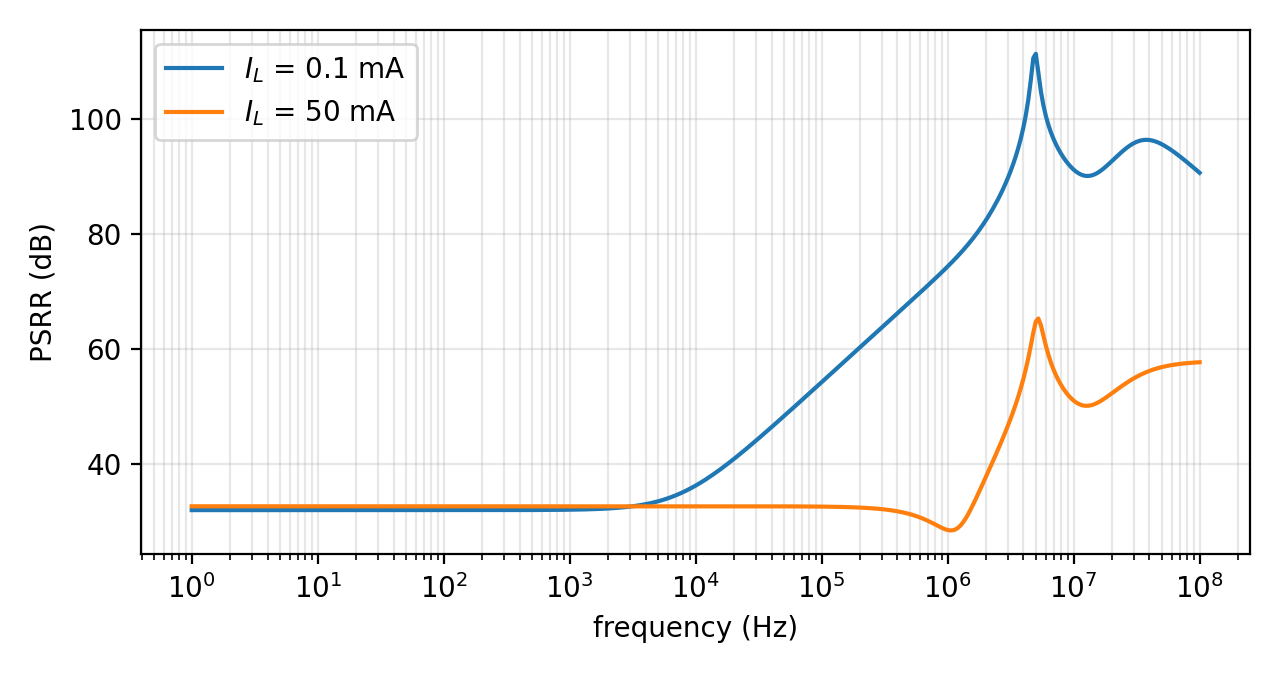
figures/psrr_v2.png
