NguyenVuQuocMinh/cmos-ldo-regulator-180nm/figures/psrr_v3.png

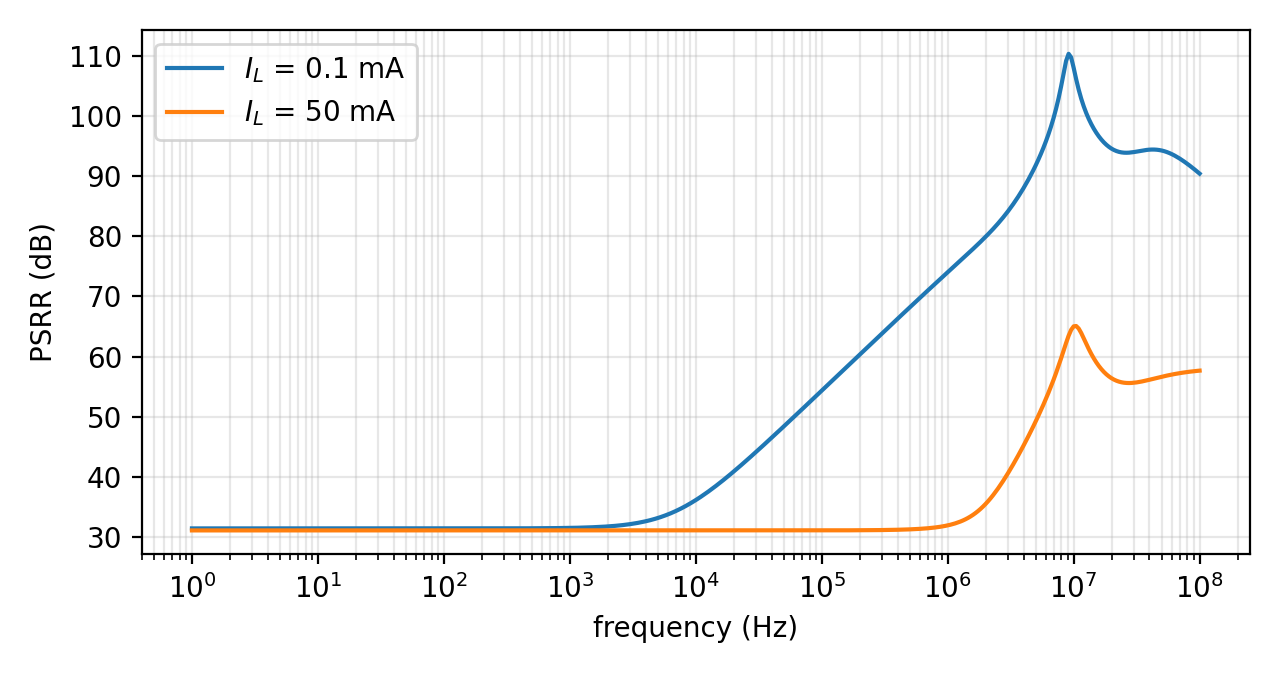
figures/psrr_v3.png
