NguyenVuQuocMinh/cmos-ldo-regulator-180nm/figures/schematic.png

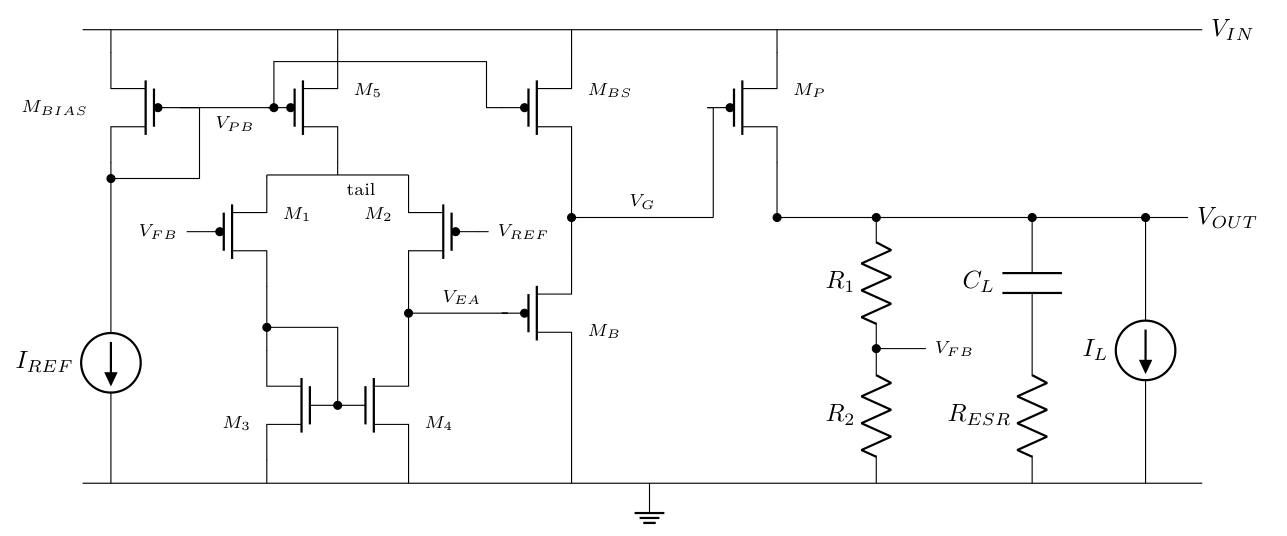
figures/schematic.png
