NguyenVuQuocMinh/cmos-ldo-regulator-180nm/netlists/ldo_v4_op.cir

* LDO op point heavy
.include cmos180.lib
iref pb 0 5e-06
mbias pb pb vin vin PMOS W=5e-06 L=1e-06 M=1 AD=2.5e-12 AS=2.5e-12 PD=1.1e-05 PS=1.1e-05
m5 tail pb vin vin PMOS W=4e-05 L=1e-06 M=1 AD=2e-11 AS=2e-11 PD=8.1e-05 PS=8.1e-05
m1 d1 fbi tail tail PMOS W=8.1e-05 L=1e-06 M=1 AD=4.05e-11 AS=4.05e-11 PD=0.000163 PS=0.000163
m2 ea vref tail tail PMOS W=8.1e-05 L=1e-06 M=1 AD=4.05e-11 AS=4.05e-11 PD=0.000163 PS=0.000163
m3 d1 d1 0 0 NMOS W=2.5e-05 L=3e-06 M=1 AD=1.25e-11 AS=1.25e-11 PD=5.1e-05 PS=5.1e-05
m4 ea d1 0 0 NMOS W=2.5e-05 L=3e-06 M=1 AD=1.25e-11 AS=1.25e-11 PD=5.1e-05 PS=5.1e-05
vref vref 0 0.6
mbs g pb vin vin PMOS W=2e-05 L=1e-06 M=1 AD=1e-11 AS=1e-11 PD=4.1e-05 PS=4.1e-05
mb 0 ea g g PMOS W=8e-06 L=5e-07 M=1 AD=4e-12 AS=4e-12 PD=1.7e-05 PS=1.7e-05
mp vout g vin vin PMOS W=1e-05 L=1.8e-07 M=300 AD=5e-12 AS=5e-12 PD=2.1e-05 PS=2.1e-05
r1 vout fb 90000.0
r2 fb 0 59999.99999999999
cl vout nesr 2.2e-06
resr nesr 0 0.01
rshort fb fbi 1e-3
vin vin 0 1.8
il vout 0 0.05
.options gmin=1e-15
.control
op
print @mbias[id]
print @mbias[vgs]
print @mbias[vds]
print @mbias[vdsat]
print @mbias[vth]
print @mbias[gm]
print @mbias[gds]
print @m5[id]
print @m5[vgs]
print @m5[vds]
print @m5[vdsat]
print @m5[vth]
print @m5[gm]
print @m5[gds]
print @m1[id]
print @m1[vgs]
print @m1[vds]
print @m1[vdsat]
print @m1[vth]
print @m1[gm]
print @m1[gds]
print @m2[id]
print @m2[vgs]
print @m2[vds]
print @m2[vdsat]
print @m2[vth]
print @m2[gm]
print @m2[gds]
print @m3[id]
print @m3[vgs]
print @m3[vds]
print @m3[vdsat]
print @m3[vth]
print @m3[gm]
print @m3[gds]
print @m4[id]
print @m4[vgs]
print @m4[vds]
print @m4[vdsat]
print @m4[vth]
print @m4[gm]
print @m4[gds]
print @mbs[id]
print @mbs[vgs]
print @mbs[vds]
print @mbs[vdsat]
print @mbs[vth]
print @mbs[gm]
print @mbs[gds]
print @mb[id]
print @mb[vgs]
print @mb[vds]
print @mb[vdsat]
print @mb[vth]
print @mb[gm]
print @mb[gds]
print @mp[id]
print @mp[vgs]
print @mp[vds]
print @mp[vdsat]
print @mp[vth]
print @mp[gm]
print @mp[gds]
print v(vout)
print v(fb)
print v(ea)
print v(g)
print v(tail)
print v(d1)
print v(pb)
print i(vin)
.endc
.end
