NguyenVuQuocMinh/cmos-ldo-regulator-180nm/(commit log)

2026-11-05 Add 0.18 um PMOS LDO: theory proofs, hand W/L design and ngspice verification
    Two documents: Part 1 proves the design formulas, Part 2 sizes every
    device from the specification and compares hand values with simulation.
    Includes the Python flow, JSON results, figures and final netlists.
    The transistor model file is not included.
2026-11-05 Add the schematic source used by both documents
2026-11-05 Add the Electric schematic of the final design and check it against the simulations
    The v3 circuit is drawn in Electric 9.08 (schematic/ldo180.jelib, cell
    ldo180{sch}). Electric's SPICE writer exports it, and check_netlist.py
    shows that all 11 devices match the Python netlist (terminals, model,
    W, L, M, R) and that the test benches reproduce the published v3 results.
2026-11-05 Show the Electric schematic in the README; tidy its drawing
    The README now opens with the schematic exported from Electric. The
    drawing was spread out: device names and W/L sit beside each symbol,
    net labels beside the wires, wire pins carry no names, and the ground
    rail sits just below the lowest device. The circuit is unchanged:
    check_netlist.py still finds all 11 devices identical to the
    simulated netlist.
2026-11-05 Redo the hand design with Rincon-Mora's LDO design procedure (v4)
    Part 2 now sizes the regulator in the eight steps of Rincon-Mora's
    dissertation (1996, Chapter II) and the Rincon-Mora/Allen JSSC paper
    (1998): topology, feedback network, pass device (dropout and
    saturation), open-loop gain, transient budget, gain stage, buffer and
    quiescent current. Part 1 adds the worst-case load-step budget with a
    proof.
    The procedure reproduces the v3 pass device and channel lengths and
    sets the buffer bias from the gate-pole and slew conditions: 20 uA
    instead of 30 uA (v4). Simulation: Iq 84.7 -> 74.9 uA, PM at 50 mA
    71.1 -> 68.3 deg (57.0 deg worst corner with ESR = 0); regulation,
    PSRR, dropout and lo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
2026-11-05 Update the Electric schematic screenshot to v4
    The figure now shows the v4 buffer sizes (MB 8/0.5, MBS 20/1); the
    note about the old screenshot is removed from the README.
